TheBadZhang/usbMeter/hardware/usbMeter2/usbMeter2.kicad_pcb

## KiCad design hardware/usbMeter2/usbMeter2.kicad_pcb (2024-09-22)

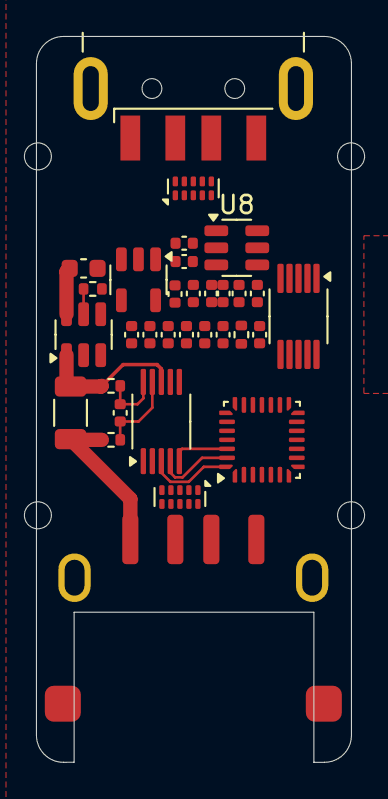
[picture p2: board usbMeter2.kicad_pcb from above]

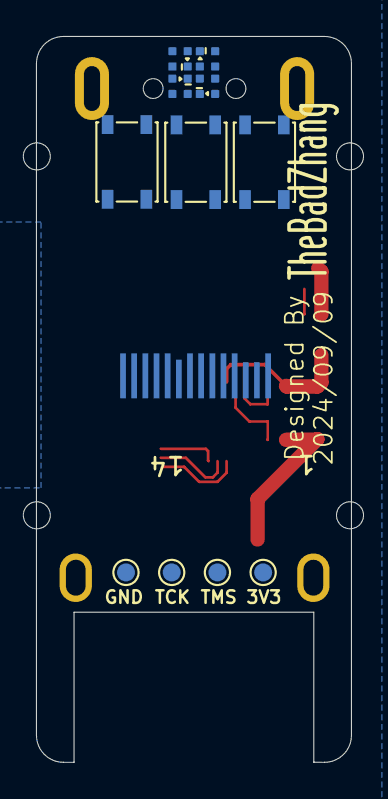
[picture p3: board usbMeter2.kicad_pcb from below]

Board: 2 copper layers, 17.5 x 40.3 mm, 48 parts (12 on the bottom side), 44 nets.

Parts:
C1, C20: 2.2uF; C_0402_1005Metric
C2, C5: 100nF; C_0402_1005Metric
C3, C4, C8, C18, C22: 0.1uF; C_0402_1005Metric
C6: 10uF; C_0603_1608Metric
C7, C10, C19, C21: 4.7uF; C_0402_1005Metric
C9: 22nF; C_0402_1005Metric
C16, C17: 1uF; C_0402_1005Metric
D1, D2, D3, D4: WS2812B-2020; ws2812-1010
H1, H2, H3, H4: MountingHole; mountinghold_nopad_m1.4
J1: USB_A; USB_A_CNCTech_1001-011-01101_Horizontal
J2: USB_A; C2763021
R3, R5: 68R; R_0402_1005Metric
R4: 20mR; R_1206_3216Metric
R6: 100k; R_0402_1005Metric
R12: 560K; R_0402_1005Metric
SW1, SW2, SW3: SW_Push; KEY-SMD_4P-L4.2-W3.4-P2.15-LS4.5-TL
TP1, TP2, TP3, TP4: TestPoint; TestPoint_Pad_D1.0mm
U1: STM32G031G8Ux; QFN-28_4x4mm_P0.5mm
U2, U3: TPD4E05U06DQA; USON-10_2.5x1.0mm_P0.5mm
U4: CH340E; MSOP-10_3x3mm_P0.5mm
U5: INA228; VSSOP-10_3x3mm_P0.5mm
U6: CH217K; TSOT-23-6
U7: RT9193-33GB; SOT-23-5
U8: TPS54202DDC; SOT-23-6
U9: iic_oled_12864_ssd1312_2

Connections:
+3V3: C1.1, C2.1, C3.1, C4.1, C10.2, C18.1, C19.1, TP3.1, U1.3 (VDD), U4.7 (VCC), U4.10 (V3), U5.6 (VS), U7.5 (Vout), U9.5 (VBAT), U9.8 (VDD)
+5V: C7.1, C8.1, U7.1 (Vin), U7.3 (EN)
/CH217_FLAG: U1.14 (PB0), U6.3 (FLAG#)
/D2+: J1.3 (D+), U3.4 (D2+), U3.7 (NC), U4.1 (UD+)
/D2-: J1.2 (D-), U3.2 (D1-), U3.9 (NC), U4.2 (UD-)
/D+: J2.3 (D+), U2.4 (D2+), U2.7 (NC)
/D-: J2.2 (D-), U2.5 (D2-), U2.6 (NC)
/KEY1: SW1.2, U1.23 (PB3)
/KEY2: SW2.2, U1.24 (PB4)
/NRST: SW3.2, U1.5 (PF2)
/OLED_RST: U1.22 (PA15), U9.9 (RES#)
/SCL1: U1.26 (PB6), U5.5 (SCL)
/SCL2: U1.18 (PA11/PA9), U9.10 (SCL)
/SDA1: U1.27 (PB7), U5.4 (SDA)
/SDA2: U1.19 (PA12/PA10), U9.11 (SDA)
/SYS_SWCLK: TP2.1, U1.21 (PA14)
/SYS_SWDIO: TP1.1, U1.20 (PA13)
/UART_RX: U1.9 (PA3), U4.8 (TXD)
/UART_TX: U1.8 (PA2), U4.9 (RXD)
/WS2812_OUT: D1.3 (DIN), U1.25 (PB5)
/ch217x/VOUT: R3.1, R4.1, U5.8 (Vbus), U6.1 (VOUT)
/~CH217_EN: U1.13 (PA7), U6.4 (EN#)
/~INA226_ALERT: U1.28 (PB8), U5.3 (~Alert)
GND: C1.2, C2.2, C3.2, C4.2, C6.1, C7.2, C8.2, C9.2, C10.1, C18.2, C19.2, C20.2, C21.2, C22.2, D1.2 (VSS), D2.2 (VSS), D3.2 (VSS), D4.2 (VSS), J1.4 (GND), J1.5 (Shield), J2.4 (GND), J2.5 (Shield), R6.1, R12.1, SW1.1, SW2.1, SW3.1, TP4.1, U1.4 (VSS), U2.3 (GND), U2.8 (GND), U3.3 (GND), U3.8 (GND), U4.3 (GND), U5.1 (A1), U5.2 (A0), U5.7 (GND), U6.2 (GND), U7.2 (GND), U8.1 (GND), U9.7 (VSS)
unnamed: D1.1 (DOUT), D2.3 (DIN)
unnamed: D2.1 (DOUT), D3.3 (DIN)
unnamed: D3.1 (DOUT), D4.3 (DIN)
unnamed: U2.1 (D1+), U2.10 (NC)
unnamed: U2.2 (D1-), U2.9 (NC)
unnamed: U3.1 (D1+), U3.10 (NC)
unnamed: U3.5 (D2-), U3.6 (NC)
unnamed: C5.1, R3.2, U5.10 (Vin+)
unnamed: C5.2, R5.2, U5.9 (Vin-)
unnamed: R6.2, U6.5 (ISET)
unnamed: C9.1, U7.4 (BP)
unnamed: C17.1, U9.4 (C1N)
unnamed: C17.2, U9.3 (C1P)
unnamed: C16.1, U9.2 (C2N)
unnamed: C16.2, U9.1 (C2P)
unnamed: R12.2, U9.12 (IREF)
unnamed: C21.1, C22.1, U9.14 (VCC)
unnamed: C20.1, U9.13 (VCOMH)
VBUS: C6.2, D1.4 (VDD), D2.4 (VDD), D3.4 (VDD), D4.4 (VDD), J1.1 (VBUS), U6.6 (VIN), U8.3 (VIN)
VBUS2: J2.1 (VBUS), R4.2, R5.1
