TheBadZhang/usbMeter/hardware/usbMeter0/usbMeter.kicad_pcb

## KiCad design hardware/usbMeter0/usbMeter.kicad_pcb (2024-09-22)

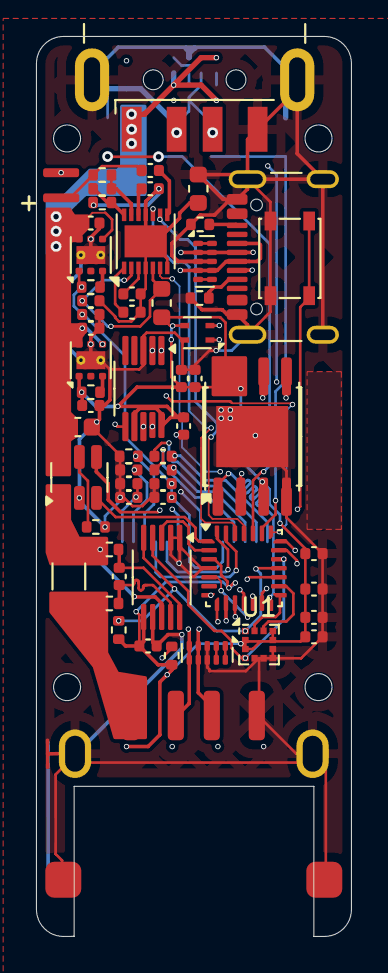
[picture p4: board usbMeter.kicad_pcb from above]

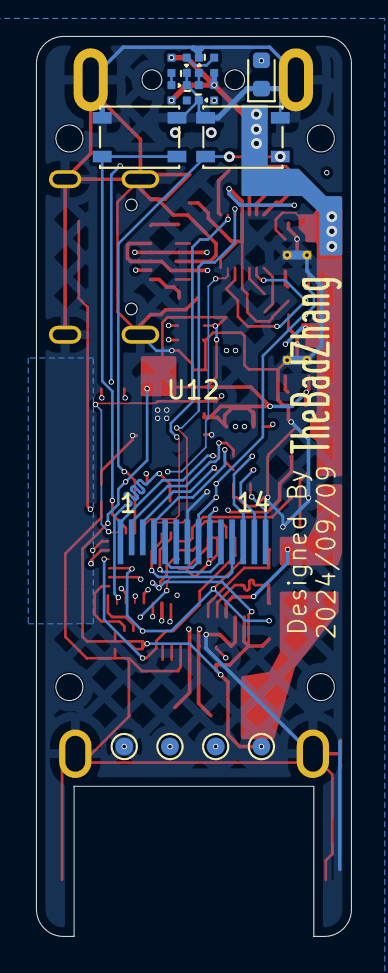
[picture p5: board usbMeter.kicad_pcb from below]

Board: 4 copper layers, 17.5 x 50.0 mm, 76 parts (12 on the bottom side), 66 nets.

Parts:
C1, C2, C9, C13: 0.1uF; C_0402_1005Metric
C3, C15, C16, C21, C22, C24, C25: 100nF; C_0402_1005Metric
C4, C19, C23: 10uF; C_0402_1005Metric
C5, C10, C12, C20: 4.7uF; C_0402_1005Metric
C6: 10uF; C_0603_1608Metric
C7, C8, C14: 1uF; C_0402_1005Metric
C11, C18, C26: 2.2uF; C_0402_1005Metric
C17: 470nF; C_0402_1005Metric
D1: LED; LED_0603_1608Metric
D2, D3, D4, D5: WS2812B-2020; ws2812-1010
H1, H2, H3, H4: MountingHole; mountinghold_nopad_m1.4
J1: USB_A; USB_A_CNCTech_1001-011-01101_Horizontal
J2: USB_A; C2763021
J3: USB_C_Receptacle_USB2.0_16P; USB_C_Receptacle_GCT_USB4105-xx-A_16P_TopMnt_Horizontal
L1, L2: FerriteBead_0603_1.5A; L_0603_1608Metric
MK1: Microphone_Condenser; MIC4015P_2
R1, R2, R6, R12, R13, R14: 5.1k; R_0402_1005Metric
R3, R5: 68R; R_0402_1005Metric
R4: 20mR; R_1206_3216Metric
R7, R11: 100k; R_0402_1005Metric
R8: 560K; R_0402_1005Metric
R9: 150k; R_0402_1005Metric
R10: 2.2k; R_0402_1005Metric
SW3, SW4, SW5: SW_Push; KEY-SMD_4P-L4.2-W3.4-P2.15-LS4.5-TL
TP1, TP2, TP3, TP4: TestPoint; TestPoint_Pad_D1.0mm
U1: LIS2HH12; LGA-12_2x2mm_P0.5mm
U2: STM32G031G8Ux; QFN-28_4x4mm_P0.5mm
U3, U8: TPD4E05U06DQA; USON-10_2.5x1.0mm_P0.5mm
U4: SHT4x; Sensirion_DFN-4_1.5x1.5mm_P0.8mm_SHT4x_NoCentralPad
U5: W25Q32JVZP; WSON-8-1EP_6x5mm_P1.27mm_EP3.4x4mm
U6: W25Q128JVS; SOIC-8_5.23x5.23mm_P1.27mm
U7: CH340E; MSOP-10_3x3mm_P0.5mm
U9: INA228; VSSOP-10_3x3mm_P0.5mm
U10, U14: LP5912-3.3DRV; WSON-6-1EP_2x2mm_P0.65mm_EP1x1.6mm_ThermalVias
U11: CH217K; TSOT-23-6
U12: iic_oled_12864_ssd1312_2
U13: MAX9814; DFN-14-1EP_3x3mm_P0.4mm_EP1.78x2.35mm

Connections:
+3V3: C1.1, C2.1, C5.1, C21.1, C22.1, C23.1, C24.1, C25.1, C26.1, L1.1, R6.1, R13.1, R14.1, TP2.1, U1.2 (~CS), U1.3 (SA0/SDO), U1.9 (Vdd), U1.10 (Vdd_IO), U2.3 (VDD), U4.3 (VDD), U5.3 (IO2), U5.7 (IO3), U5.8 (VCC), U6.3 (IO2), U6.7 (IO3), U6.8 (VCC), U7.7 (VCC), U7.10 (V3), U9.6 (VS), U10.1 (OUT)
+5V: J2.1 (VBUS), R4.2, R5.1
/ACC_INT1: U1.12 (INT1), U2.15 (PB1)
/ACC_INT2: U1.11 (INT2), U2.16 (PA8)
/ADC_IN5: U2.11 (PA5), U13.6 (MICOUT)
/A/R: U2.25 (PB5), U13.9 (A/R)
/CH217_FLAG: U2.1 (PC14), U11.3 (FLAG#)
/D2+: J3.A6 (D+), J3.B6 (D+), U7.1 (UD+), U8.4 (D2+), U8.7 (NC)
/D2-: J3.A7 (D-), J3.B7 (D-), U7.2 (UD-), U8.2 (D1-), U8.9 (NC)
/D+: J1.3 (D+), J2.3 (D+), U3.4 (D2+), U3.7 (NC)
/D-: J1.2 (D-), J2.2 (D-), U3.5 (D2-), U3.6 (NC)
/Gain: U2.26 (PB6), U13.10 (GAIN)
/KEY1: SW3.2, U2.23 (PB3)
/KEY2: SW4.2, U2.24 (PB4)
/MAX9814/B3v3: C14.1, L1.2, U13.2 (~SHDN), U13.5 (VDD)
/MAX9814/BGND: C14.2, C16.2, C17.2, C18.2, L2.2, MK1.1 (-), R11.1, U13.4 (GND), U13.7 (GND), U13.11 (GND), U13.15 (GND)
/MAX9814/BIAS: C17.1, U13.12 (BIAS)
/MAX9814/CT: C16.1, U13.1 (CT)
/MAX9814/MICBIAS: R9.1, R10.2, U13.13 (MICBIAS)
/MAX9814/MICIN: C15.1, U13.8 (MICIN)
/MAX9814/TH: R9.2, R11.2, U13.14 (TH)
/NRST: SW5.2, U2.5 (PF2)
/OLED_RST: U2.22 (PA15), U12.9 (RES#)
/OLED_VCC: C9.1, C10.1, C20.1, R12.1, U12.5 (VBAT), U12.8 (VDD), U14.1 (OUT)
/SCL: U2.28 (PB8), U12.10 (SCL)
/SCL2: R14.2, U1.1 (SCL/SPC), U2.18 (PA11/PA9), U4.2 (SCL), U9.5 (SCL)
/SDA: U2.27 (PB7), U12.11 (SDA)
/SDA2: R13.2, U1.4 (SDA/SDI), U2.19 (PA12/PA10), U4.1 (SDA), U9.4 (SDA)
/SPI_CLK: U2.7 (PA1), U5.6 (CLK), U6.6 (CLK)
/SPI_MISO: U2.12 (PA6), U5.2 (DO(IO1)), U6.2 (DO(IO1))
/SPI_MOSI: U2.13 (PA7), U5.5 (DI(IO0)), U6.5 (DI(IO0))
/SPI_NSS: U2.14 (PB0), U5.1 (~CS), U6.1 (~CS)
/SYS_SWCLK: TP3.1, U2.21 (PA14)
/SYS_SWDIO: TP4.1, U2.20 (PA13)
/UART_RX: U2.9 (PA3), U7.8 (TXD)
/UART_TX: U2.8 (PA2), U7.9 (RXD)
/WS2812_OUT: D2.3 (DIN), U2.10 (PA4)
/ch217x/VOUT: R3.1, R4.1, U9.8 (Vbus), U11.1 (VOUT)
/~CH217_EN: U2.17 (PC6), U11.4 (EN#)
/~INA226_ALERT: U2.2 (PC15), U9.3 (~Alert)
GND: C1.2, C2.2, C4.2, C5.2, C6.1, C9.2, C10.2, C11.2, C12.2, C13.2, C19.2, C20.2, C21.2, C22.2, C23.2, C24.2, C25.2, C26.2, D1.1 (K), D2.2 (VSS), D3.2 (VSS), D4.2 (VSS), D5.2 (VSS), J1.4 (GND), J1.5 (Shield), J2.4 (GND), J2.5 (Shield), J3.A1 (GND), J3.A12 (GND), J3.B1 (GND), J3.B12 (GND), J3.S1 (SHIELD), L2.1, R1.2, R2.2, R7.1, R8.1, SW3.1, SW4.1, SW5.1, TP1.1, U1.5 (RES), U1.6 (GND), U1.7 (GND), U1.8 (GND), U2.4 (VSS), U3.3 (GND), U3.8 (GND), U4.4 (VSS), U5.4 (GND), U5.9 (EP), U6.4 (GND), U7.3 (GND), U8.3 (GND), U8.8 (GND), U9.1 (A1), U9.2 (A0), U9.7 (GND), U10.5 (GND), U10.7 (EP), U11.2 (GND), U12.7 (VSS), U14.5 (GND), U14.7 (EP)
unnamed: D1.2 (A), U7.6 (TNOW)
unnamed: D2.1 (DOUT), D3.3 (DIN)
unnamed: D3.1 (DOUT), D4.3 (DIN)
unnamed: D4.1 (DOUT), D5.3 (DIN)
unnamed: J3.A5 (CC1), R2.1
unnamed: J3.B5 (CC2), R1.1
unnamed: C15.2, MK1.2 (+), R10.1
unnamed: U3.1 (D1+), U3.10 (NC)
unnamed: U3.2 (D1-), U3.9 (NC)
unnamed: U8.1 (D1+), U8.10 (NC)
unnamed: U8.5 (D2-), U8.6 (NC)
unnamed: C3.1, R3.2, U9.10 (Vin+)
unnamed: C3.2, R5.2, U9.9 (Vin-)
unnamed: R6.2, U10.3 (PG)
unnamed: R7.2, U11.5 (ISET)
unnamed: C8.1, U12.4 (C1N)
unnamed: C8.2, U12.3 (C1P)
unnamed: C7.1, U12.2 (C2N)
unnamed: C7.2, U12.1 (C2P)
unnamed: R8.2, U12.12 (IREF)
unnamed: C12.1, C13.1, U12.14 (VCC)
unnamed: C11.1, U12.13 (VCOMH)
unnamed: C18.1, U13.3 (CG)
unnamed: R12.2, U14.3 (PG)
VBUS: C4.1, C6.2, C19.1, D2.4 (VDD), D3.4 (VDD), D4.4 (VDD), D5.4 (VDD), J1.1 (VBUS), U10.4 (EN), U10.6 (IN), U11.6 (VIN), U14.4 (EN), U14.6 (IN)
