TheBadZhang/usbMeter/software/usbMeter.ioc

Mcu.UserName=STM32G031G8Ux
PA1.Signal=SPI1_SCK
PA13.Signal=SYS_SWDIO
PA14-BOOT0.Signal=SYS_SWCLK
PA15.GPIO_Label=OLED_RST
PA15.Signal=GPIO_Output
PA2.Signal=USART2_TX
PA3.Signal=USART2_RX
PA7.GPIO_Label=CH217_EN
PA7.Signal=GPIO_Output
PB0.GPIO_Label=CH217_FLAG
PB0.Signal=GPXTI0
PB3.GPIO_Label=KEY1
PB3.Signal=GPIO_Input
PB4.GPIO_Label=KEY2
PB4.Signal=GPIO_Input
PB5.Signal=SPI1_MOSI
PB6.Signal=I2C1_SCL
PB7.Signal=I2C1_SDA
PC6.GPIO_Label=INA226_ALERT
PC6.Signal=GPXTI6
