TheBadZhang/usbMeter/software/src/img.c

#include <stdint.h>

const uint8_t usbmeter1[] = {
	0xff, 0xff, 0x83, 0x3f, 0xff, 0xff, 0xff, 0x03, 0x03, 0xff,
	0xff, 0xc7, 0x83, 0xbb, 0x3b, 0x7f, 0xff, 0xff, 0x03, 0x03,
	0x3b, 0x33, 0x37, 0x07, 0xff, 0x1f, 0x07, 0xe7, 0x07, 0x7f,
	0x07, 0xe7, 0x07, 0x1f, 0xff, 0xff, 0xff, 0x3f, 0xbf, 0xbf,
	0x3f, 0xff, 0xff, 0x7f, 0x0f, 0x0f, 0x7f, 0xff, 0xff, 0x3f,
	0xbf, 0xbf, 0x3f, 0xff, 0xff, 0xff, 0xdf, 0x3f, 0x7f, 0x3f,
	0xbf, 0xff, 0xff, 0xff, 0x7f, 0x7f, 0x7f, 0x7c, 0x79, 0x73,
	0x73, 0x70, 0x70, 0x7f, 0x7f, 0x77, 0x77, 0x73, 0x78, 0x7c,
	0x7f, 0x7f, 0x70, 0x70, 0x77, 0x77, 0x73, 0x78, 0x7f, 0x78,
	0x7e, 0x7f, 0x7e, 0x78, 0x7e, 0x7f, 0x7f, 0x7c, 0x78, 0x7f,
	0x7e, 0x78, 0x7a, 0x7a, 0x7a, 0x7b, 0x7b, 0x7f, 0x78, 0x78,
	0x7b, 0x7f, 0x7e, 0x78, 0x7a, 0x7a, 0x7a, 0x7b, 0x7b, 0x7f,
	0x7f, 0x70, 0x7f, 0x7f, 0x7f, 0x7f, 0x7f, 0x7f
};

const uint8_t usbmeter2[] = {
	0xff, 0xff, 0x0f, 0xff, 0xff, 0xff, 0x0f, 0xff, 0xff, 0xff,
	0x9f, 0x6f, 0x6f, 0x6f, 0xdf, 0xff, 0xff, 0xff, 0x0f, 0x6f,
	0x6f, 0x6f, 0x9f, 0xff, 0xff, 0xff, 0x0f, 0xbf, 0x7f, 0xbf,
	0x0f, 0xff, 0xff, 0xff, 0x7f, 0xbf, 0xbf, 0x7f, 0xff, 0xff,
	0xff, 0xbf, 0x1f, 0xbf, 0xbf, 0xff, 0xff, 0xff, 0xff, 0xff,
	0x7f, 0xbf, 0xbf, 0x7f, 0xff, 0xff, 0xff, 0xff, 0x3f, 0x7f,
	0xbf, 0xbf, 0xff, 0xff, 0x7f, 0x7f, 0x7c, 0x7b, 0x7b, 0x7b,
	0x7c, 0x7f, 0x7f, 0x7f, 0x7d, 0x7b, 0x7b, 0x7b, 0x7c, 0x7f,
	0x7f, 0x7f, 0x78, 0x7b, 0x7b, 0x7b, 0x7c, 0x7f, 0x7f, 0x7f,
	0x78, 0x7f, 0x7e, 0x7f, 0x78, 0x7f, 0x7f, 0x7f, 0x7c, 0x7a,
	0x7a, 0x7e, 0x7f, 0x7f, 0x7f, 0x7f, 0x7c, 0x7b, 0x7b, 0x7f,
	0x7f, 0x7f, 0x7f, 0x7f, 0x7c, 0x7a, 0x7a, 0x7e, 0x7f, 0x7f,
	0x7f, 0x7f, 0x78, 0x7f, 0x7f, 0x7f, 0x7f, 0x7f
};

const uint8_t usbmeter3[] = {
	0xff, 0x03, 0x03, 0xff, 0xff, 0xff, 0x03, 0xff, 0x87, 0x83,
	0xbb, 0x3b, 0x3b, 0x77, 0xff, 0x03, 0x03, 0xbb, 0xbb, 0x57,
	0xef, 0xff, 0xff, 0x0f, 0x07, 0xf3, 0x07, 0xff, 0x07, 0x07,
	0xf3, 0x87, 0x3f, 0xff, 0xff, 0x3f, 0x1f, 0x6f, 0x6f, 0x5f,
	0xbf, 0xff, 0xdf, 0xdf, 0x07, 0x07, 0xdf, 0xdf, 0xff, 0x3f,
	0x1f, 0x6f, 0x6f, 0x5f, 0xbf, 0xff, 0xdf, 0x1f, 0x3f, 0x9f,
	0xdf, 0xff, 0xff, 0xff, 0x7f, 0x78, 0x70, 0x77, 0x77, 0x73,
	0x78, 0x7f, 0x7b, 0x77, 0x77, 0x73, 0x70, 0x78, 0x7f, 0x70,
	0x70, 0x77, 0x77, 0x7b, 0x7c, 0x7f, 0x7f, 0x70, 0x70, 0x7f,
	0x7c, 0x71, 0x70, 0x7c, 0x7f, 0x7f, 0x70, 0x7f, 0x7f, 0x7c,
	0x78, 0x7b, 0x7b, 0x7b, 0x7d, 0x7f, 0x7f, 0x7f, 0x70, 0x70,
	0x73, 0x73, 0x7f, 0x7c, 0x78, 0x7b, 0x7b, 0x7b, 0x7d, 0x7f,
	0x7f, 0x78, 0x7f, 0x7f, 0x7f, 0x7f, 0x7f, 0x7f
};
