TheBadZhang/usbMeter/(commit log)

2024-09-22 usbMeter 软件部分，基本功能开发进度95%
2024-09-22 usbMeter 硬件部分，V1.0设计完成
    还有一些可以优化的部分，之后将产生后续的版本，此版本功能一切正常
    [ch217x.kicad_sch, ina228.kicad_sch, lp5912.kicad_sch, ssd1306.kicad_sch, usbMeter.kicad_pcb, usbMeter.kicad_sch]
2024-09-22 更新 readme 文件
2024-09-22 根据不同的硬件版本对硬件进行分类
    [ch217x.kicad_sch, ina228.kicad_sch, lp5912.kicad_sch, ssd1306.kicad_sch, usbMeter.kicad_pcb, usbMeter.kicad_sch]
2024-09-22 添加了对旧版本的描述
    [ch217x.kicad_sch, dual_flash.kicad_sch, ina228.kicad_sch, lis2h.kicad_sch, lp5912.kicad_sch, max9814.kicad_sch, sht40.kicad_sch, ssd1306.kicad_sch]
2024-09-22 开始计划 V2.0.0 的开发
    [ch217x.kicad_sch, ina228.kicad_sch, rt9193-33GB.kicad_sch, ssd1306.kicad_sch, usbMeter2.kicad_pcb, usbMeter2.kicad_sch]
2024-09-22 更新一张效果图
2024-09-22 优化了 ina226 相关的代码，解耦优化
    在此处遇到一个很奇怪的问题，current变量时不时打印的时候会变成一个很大的值，但是并不知道是为什么，计算了current_ls*2^15并不会超过1000，但是它得到了一个很大的值，2600左右，后来想在它显示这个值之前打印出来具体的数值，结果问题就消失了，看来是额外的对current变量的操作导致了问题，把它设置成 volatile 并没有什么效果，后来在编译选项的优化选项从Og改成了O2，问题就解决了，而且没有复现
    [core.cc, ina226.c, ina226.h]
2024-09-22 上一个commit的部分解释
    看了一下，Og选项把xprintf库的体积优化了50%，估计在这丢失了很多奇怪的东西
2024-09-22 验证下来xprintf这个库还是不够稳健
    最终还是更换为标准库，相比xprintf库，格式化浮点数的时候，会额外增加10K code
2024-09-22 usbmeter2尝试缩减了本体的尺寸，采用dcdc+ldo供电避免typea可能存在的高压输入
    [rt9193-33GB.kicad_sch, ssd1306.kicad_sch, tps54202-3v3.kicad_sch, usbMeter2.kicad_pcb, usbMeter2.kicad_sch]
2024-09-22 优化了浮点数输出的代码，增加了更多字体支持，优化了界面表现
